JF717/GPS-Collars/README.md

# GPS-Collars
Instructions for the construction and programming of Arduino based GPS collars
