JF717/GPS-Collars/collar specs.xlsx

Part | cost |  | Weight (g) | Link
Board+datalogger | 22.5 |  | 5.3 | https://shop.pimoroni.com/products/adafruit-feather-m0-adalogger
GPS board | 40 |  | 8.8 | https://shop.pimoroni.com/collections/adafruit-uk-distributor/products/adafruit-ultimate-gps-featherwing
Accelerometer | 9.4 |  | 1.3 | https://www.amazon.co.uk/Adafruit-LIS3DH-Triple-Axis-Accelerometer-2g/dp/B01BU70B64/
Battery | 4 |  | 95 | 2 x 2200 mAh Battery available numerous locations
Micro SD | 3 |  | 0.5 | https://www.amazon.co.uk/d/Memory-Cards/Micro-Memory-Adapter-Ericson-Xperia/B005H10L9W
Collar | 13.75 |  | 118 | https://www.amazon.co.uk/EzyDog-Neo-Collar-Medium-39-44cm/dp/B002Q9X0W8/
Plastic housing | 4 |  | 11 | http://www.bodleian.ox.ac.uk/science/use/3d-printing
Total | 96.65 | Total g | 239.9
