JF717/GPS-Collars/BatteryBox2.stl

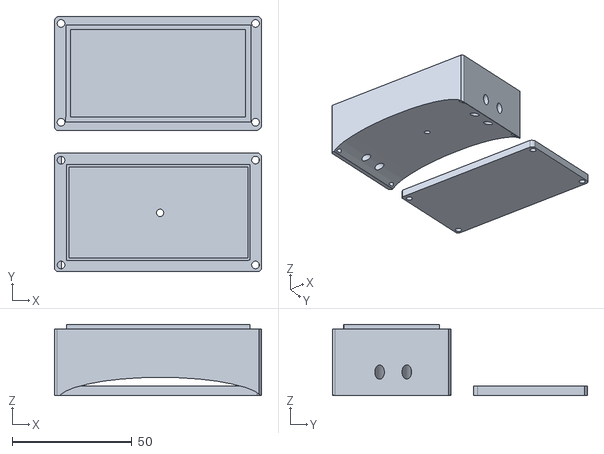
[picture p8: CAD file, 2017-12-04]
BatteryBox2.stl
86.4 x 106.3 x 29.8
