JF717/GPS-Collars/CollarBox 2.stl

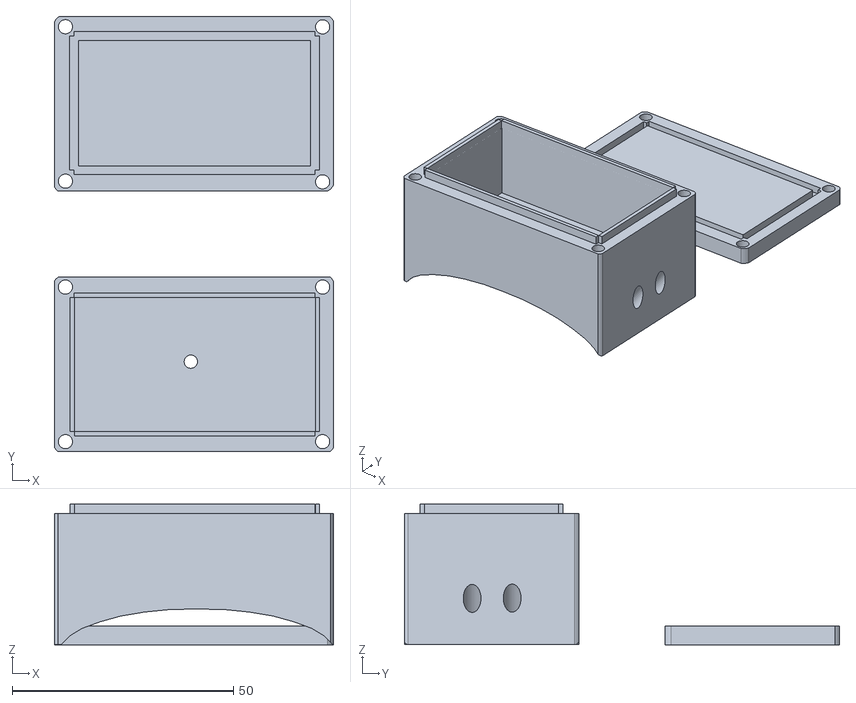
[picture p9: CAD file, 2017-12-04]
CollarBox 2.stl
63.0 x 98.2 x 31.8
